kaviish123/environode-esp32-can/docs/ESP32_CAN_Wiring_Diagrams.html

# ESP32 Environment Monitor: Wiring Diagrams

Stage 1 is one ESP32 on one breadboard. Stage 2 adds a second ESP32 and connects the two over CAN bus.

## Stage 1: Single ESP32

Module pin | Connect to
BME280 VCC / GND | 3.3V rail / GND rail
BME280 SDA / SCL | GPIO21 / GPIO22
OLED VCC / GND | 3.3V rail / GND rail
OLED SDA / SCL | GPIO21 / GPIO22 (shared with BME280)
SD VCC / GND | 5V rail (VIN) / GND rail
SD CS / SCK / MOSI / MISO | GPIO5 / GPIO18 / GPIO23 / GPIO19
Green LED / Red LED / Buzzer (+) | GPIO25 / GPIO26 / GPIO27 (LEDs through 220 ohm)
LED and buzzer (-) | GND rail
ESP32 3V3 / VIN / GND | 3.3V rail / 5V rail / GND rail

## Stage 2: Two-node CAN bus system

### Sensor node (ESP32 #1)

Module pin | Connect to
BME280 VCC / GND | Node 1 3.3V rail / GND rail
BME280 SDA / SCL | ESP32 #1 GPIO21 / GPIO22
CAN module #1 CTX / CRX | ESP32 #1 GPIO17 / GPIO16
CAN module #1 3V3 / GND | Node 1 3.3V rail / GND rail
CAN module #1 CANH / CANL | CAN module #2 CANH / CANL (twisted pair)

### Gateway node (ESP32 #2)

Module pin | Connect to
CAN module #2 CTX / CRX | ESP32 #2 GPIO17 / GPIO16
CAN module #2 3V3 / GND | Node 2 3.3V rail / GND rail
OLED SDA / SCL | ESP32 #2 GPIO21 / GPIO22
OLED VCC / GND | Node 2 3.3V rail / GND rail
SD CS / SCK / MOSI / MISO | ESP32 #2 GPIO5 / GPIO18 / GPIO23 / GPIO19
SD VCC / GND | Node 2 5V rail / GND rail
LEDs / Buzzer (+) | GPIO25 / GPIO26 / GPIO27
Node 1 GND rail | Node 2 GND rail (one extra wire)

Before powering on: unplug USB while wiring, check 3.3V and 5V are not swapped, confirm the sensor says BME280 (not BMP280), and wire and test one module at a time.
