kaviish123/environode-esp32-can/docs/stage1_wiring.png

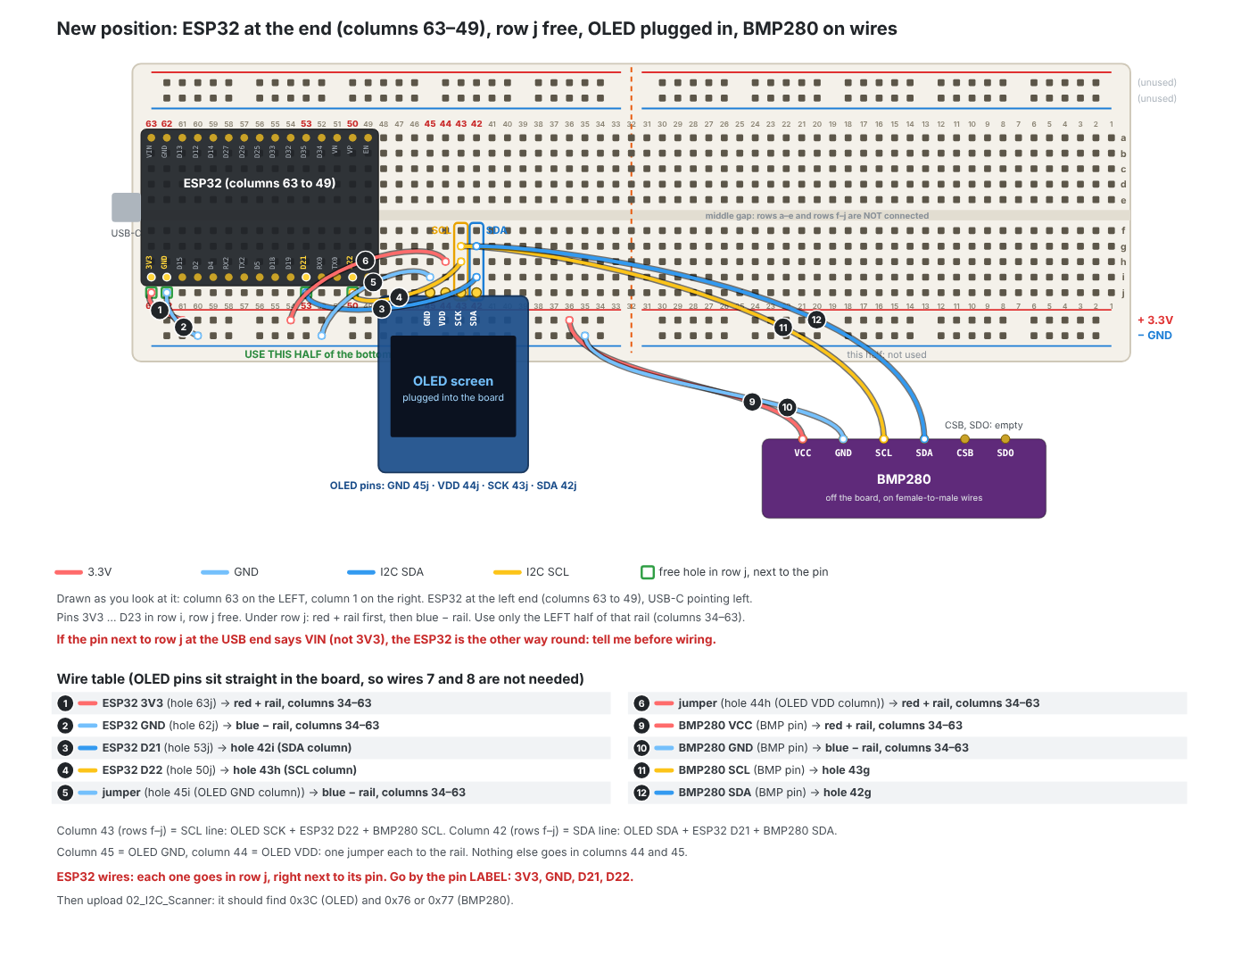
docs/stage1_wiring.png
