kaviish123/environode-esp32-can/docs/stage2_wiring.png

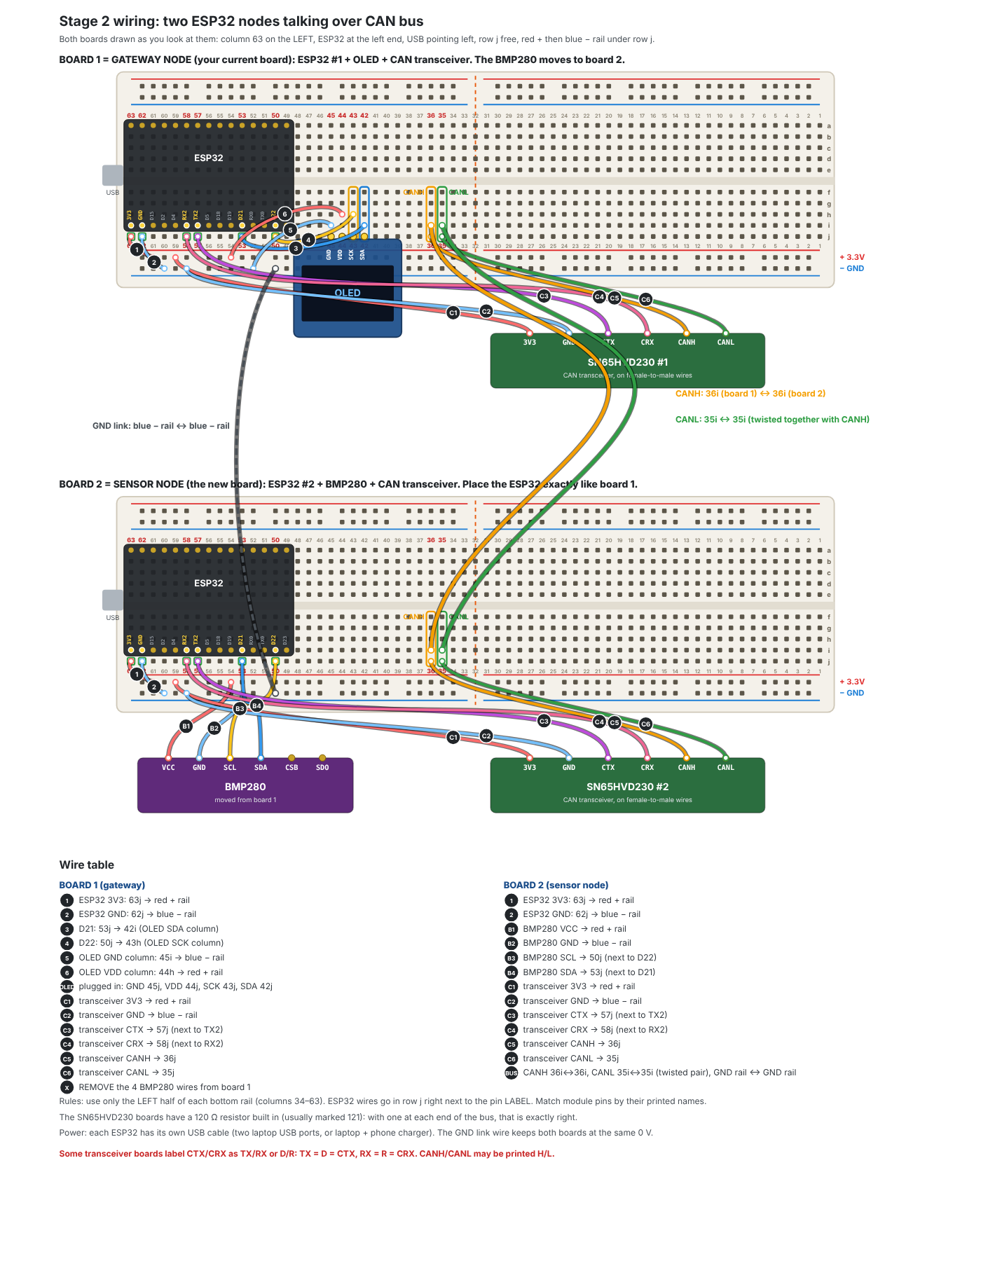
docs/stage2_wiring.png
